uzair63210-png/plus-box/PULSE-Box_Round_3D_model.obj

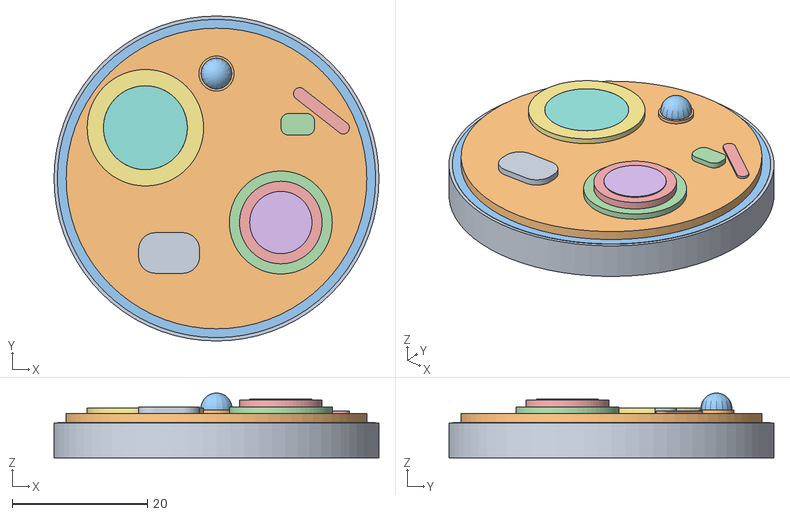
[picture p1: CAD file, 2026-10-22]
PULSE-Box_Round_3D_model.obj
48.0 x 48.0 x 9.60
enclosure
lid
gasket
cell_ring
coin_cell
cell_label
write_coil
coil_core
uv_window
led_base
led_dome
antenna_chip
antenna_strip
