uzair63210-png/plus-box/PULSE-Box_Schematic_Rev-A.pdf

PULSE-Box Tag — Board Schematic | Sheet 1/2 · analog front-end, power, MCU and 433.92 MHz FSK transmitter · Rev A

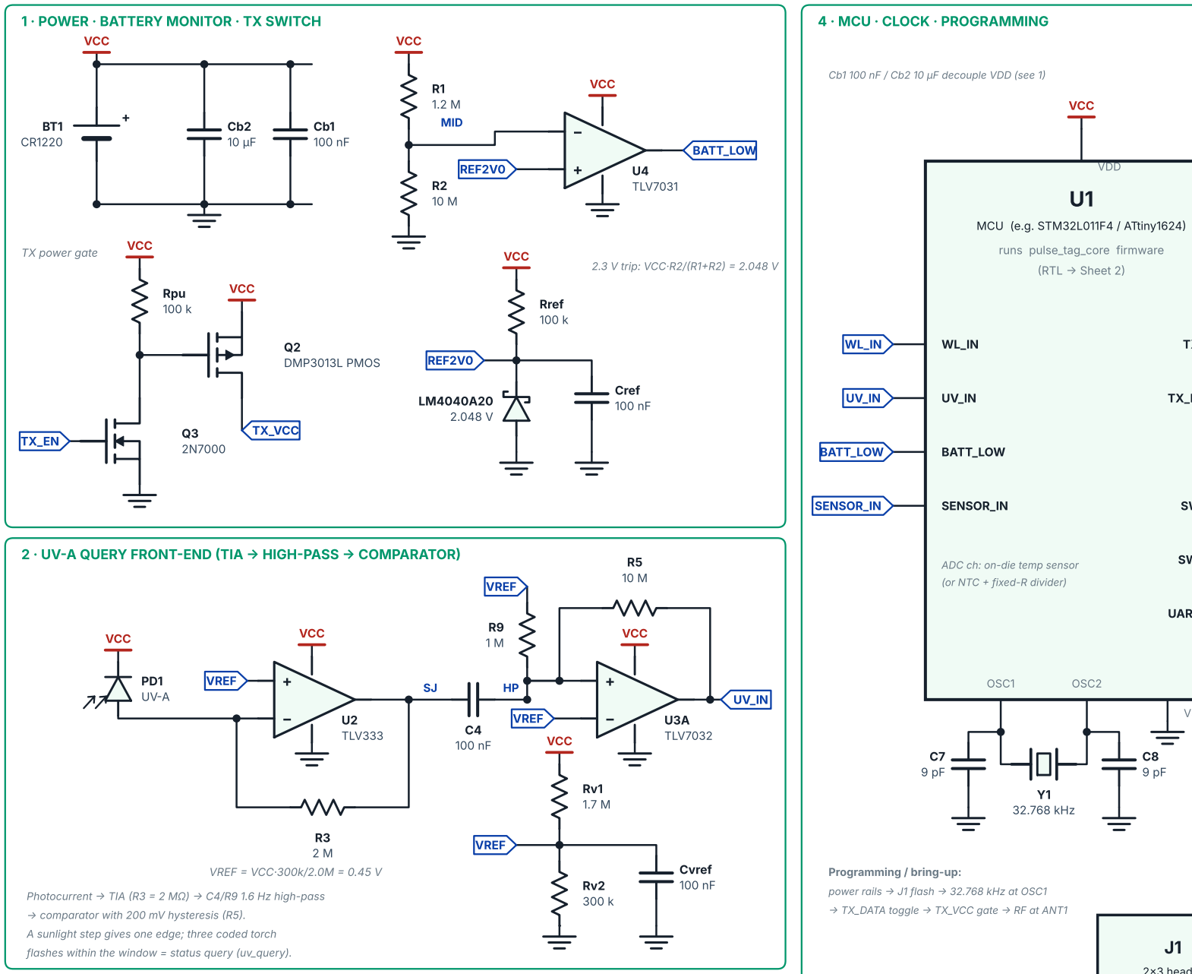
[picture p2: figure]
1 · POWER · BATTERY MONITOR · TX SWITCH; VCC; TLV7031; REF2V0; BATT_LOW; MID; Rref 100 k; Cref 100 nF; 2.3 V trip: VCC·R2/(R1+R2) = 2.048 V; Q2 DMP3013L PMOS; TX_VCC; Rpu 100 k; TX power gate; TLV333; VREF; TLV7032; Cvref 100 nF; VREF = VCC·300k/2.0M = 0.45 V; 4 · MCU · CLOCK · PROGRAMMING; MCU (e.g. STM32L011F4 / ATtiny1624); runs pulse_tag_core firmware; (RTL → Sheet 2); SENSOR_IN; ADC ch: on-die temp sensor (or NTC + fixed-R divider); VDD; OSC1; OSC2; Y1 32.768 kHz; Programming / bring-up:

### 2 · UV-A QUERY FRONT-END (TIA → HIGH-PASS → COMPARATOR)

Photocurrent → TIA (R3 = 2 MΩ) → C4/R9 1.6 Hz high-pass

→ comparator with 200 mV hysteresis (R5).

A sunlight step gives one edge; three coded torch
flashes within the window = status query (uv_query).

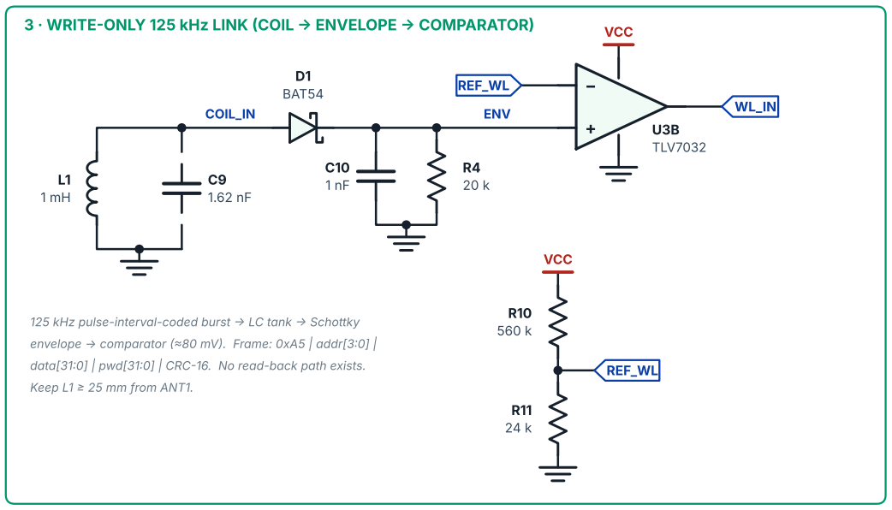
[picture p3: figure]
COIL_IN; D1 BAT54; ENV; TLV7032; REF_WL; VCC; Keep L1 ≥ 25 mm from ANT1.

### 3 · WRITE-ONLY 125 kHz LINK (COIL → ENVELOPE → COMPARATOR)

125 kHz pulse-interval-coded burst → LC tank → Schottky

envelope → comparator (≈80 mV). Frame: 0xA5 | addr[3:0] |
data[31:0] | pwd[31:0] | CRC-16. No read-back path exists.
TX_EN | TX_EN
TX_DATA | TX_DATA
SWDIO | SWDIO
SWCLK | SWCLK
UART_TX | UART_TX

VSS

Cb1 100 nF / Cb2 10 µF decouple VDD (see 1)

2×3 header
SWD + UART
VCC | 1
GND | 2
SWDIO | 3
SWCLK | 4
UART_TX | 5
NC × | 6

power rails → J1 flash → 32.768 kHz at OSC1

→ TX_DATA toggle → TX_VCC gate → RF at ANT1

### 5 · 433.92 MHz FSK TRANSMITTER (SAW-STABILISED COMMON-BASE COLPITTS)

TX_VCC

RB1
10 k

RB2
10 k

CB
1 nF
VB | Q1
| BFP420

L3
27 nH RFC

COL

SAW1

433.92 MHz

1 | 3 2

C1
15 pF

RE*
1.5 k

C2
33 pF

VC

D2
1SV325

R6
100 k

TX_DATA

Cout
10 pF

C12
12 pF*

L2
12 nH

C13
12 pF*

ANT1
433.92 MHz helical
or PCB meander

RF_OUT

π match (C12 · L2 · C13) — pads tunable on bench

TX_EN → Q3 → Q2 gates TX_VCC (radio is unpowered between packets).

TX_DATA (0/VCC) through R6 pulls varactor D2 → ±36 kHz FSK shift.

Emitter node needs a DC return: RE (dashed) is NOT in the BOM — see review note R2.

* = simulated / bench-tuned value

TX link budget (from RTL)

433.92 MHz · 2-FSK ±36 kHz · NRZ 4096 bit/s (32.768 kHz ÷ 8)

96-bit frame: preamble 0xAA (8) | sync 0x2DD4 (16) | box ID (32) |
status (8) | sample (8) | seq (8) | CRC-16/CCITT (16)

Heartbeat 6 h + jitter; alert back-off 10 s → 300 s; UV query on demand

### DESIGN & REVIEW NOTES

Design

### 1 Pilot option: replace Q1/SAW1/D2 with a sub-GHz SoC module (E22-900M / STM32WL):

TX_DATA→DIN, TX_EN→sleep.

2 UV photodiode needs a clear optical window in the label / enclosure.

3 Solid ground plane under RF; keep L1 ≥ 25 mm from ANT1; π-match pads left tunable.

Review flags (vs. original package)

R1 | BOM/netlist put Q2 source on TX_VCC; drawn here as source = VCC, drain = TX_VCC (correct high-side switch).
R2 | Q1 emitter has no DC path to GND in the BOM → RE ≈ 1–2.2 kΩ added (dashed). Confirm in
| simulation.
R3 | R10/R11 on VCC give 3.0·24/584 ≈ 123 mV, not 80 mV. For 80 mV use R10 ≈ 866 kΩ.
R4 | J1 pin 6 not defined in the source (drawn NC).

## PULSE-Box — Reusable Shelf-Life Monitoring Tag

Board Schematic · power, sensing, MCU, RF

Sheet 1 of 2 · Format A3

Rev A · 2026-10-16

Passives 0603 unless noted · * = tuned value

Team VK26-IITI-AHM-0520

Vishwakarma Awards 2026-27 · Stage 2

Source: netlist.csv, BOM.csv, RTL

Red = power · blue = net name

PULSE-Box Tag — Digital Core (pulse_tag_core.v) | Sheet 2/2 · RTL block schematic: every instance, port and net from the Verilog · Rev A

### wlink_rx

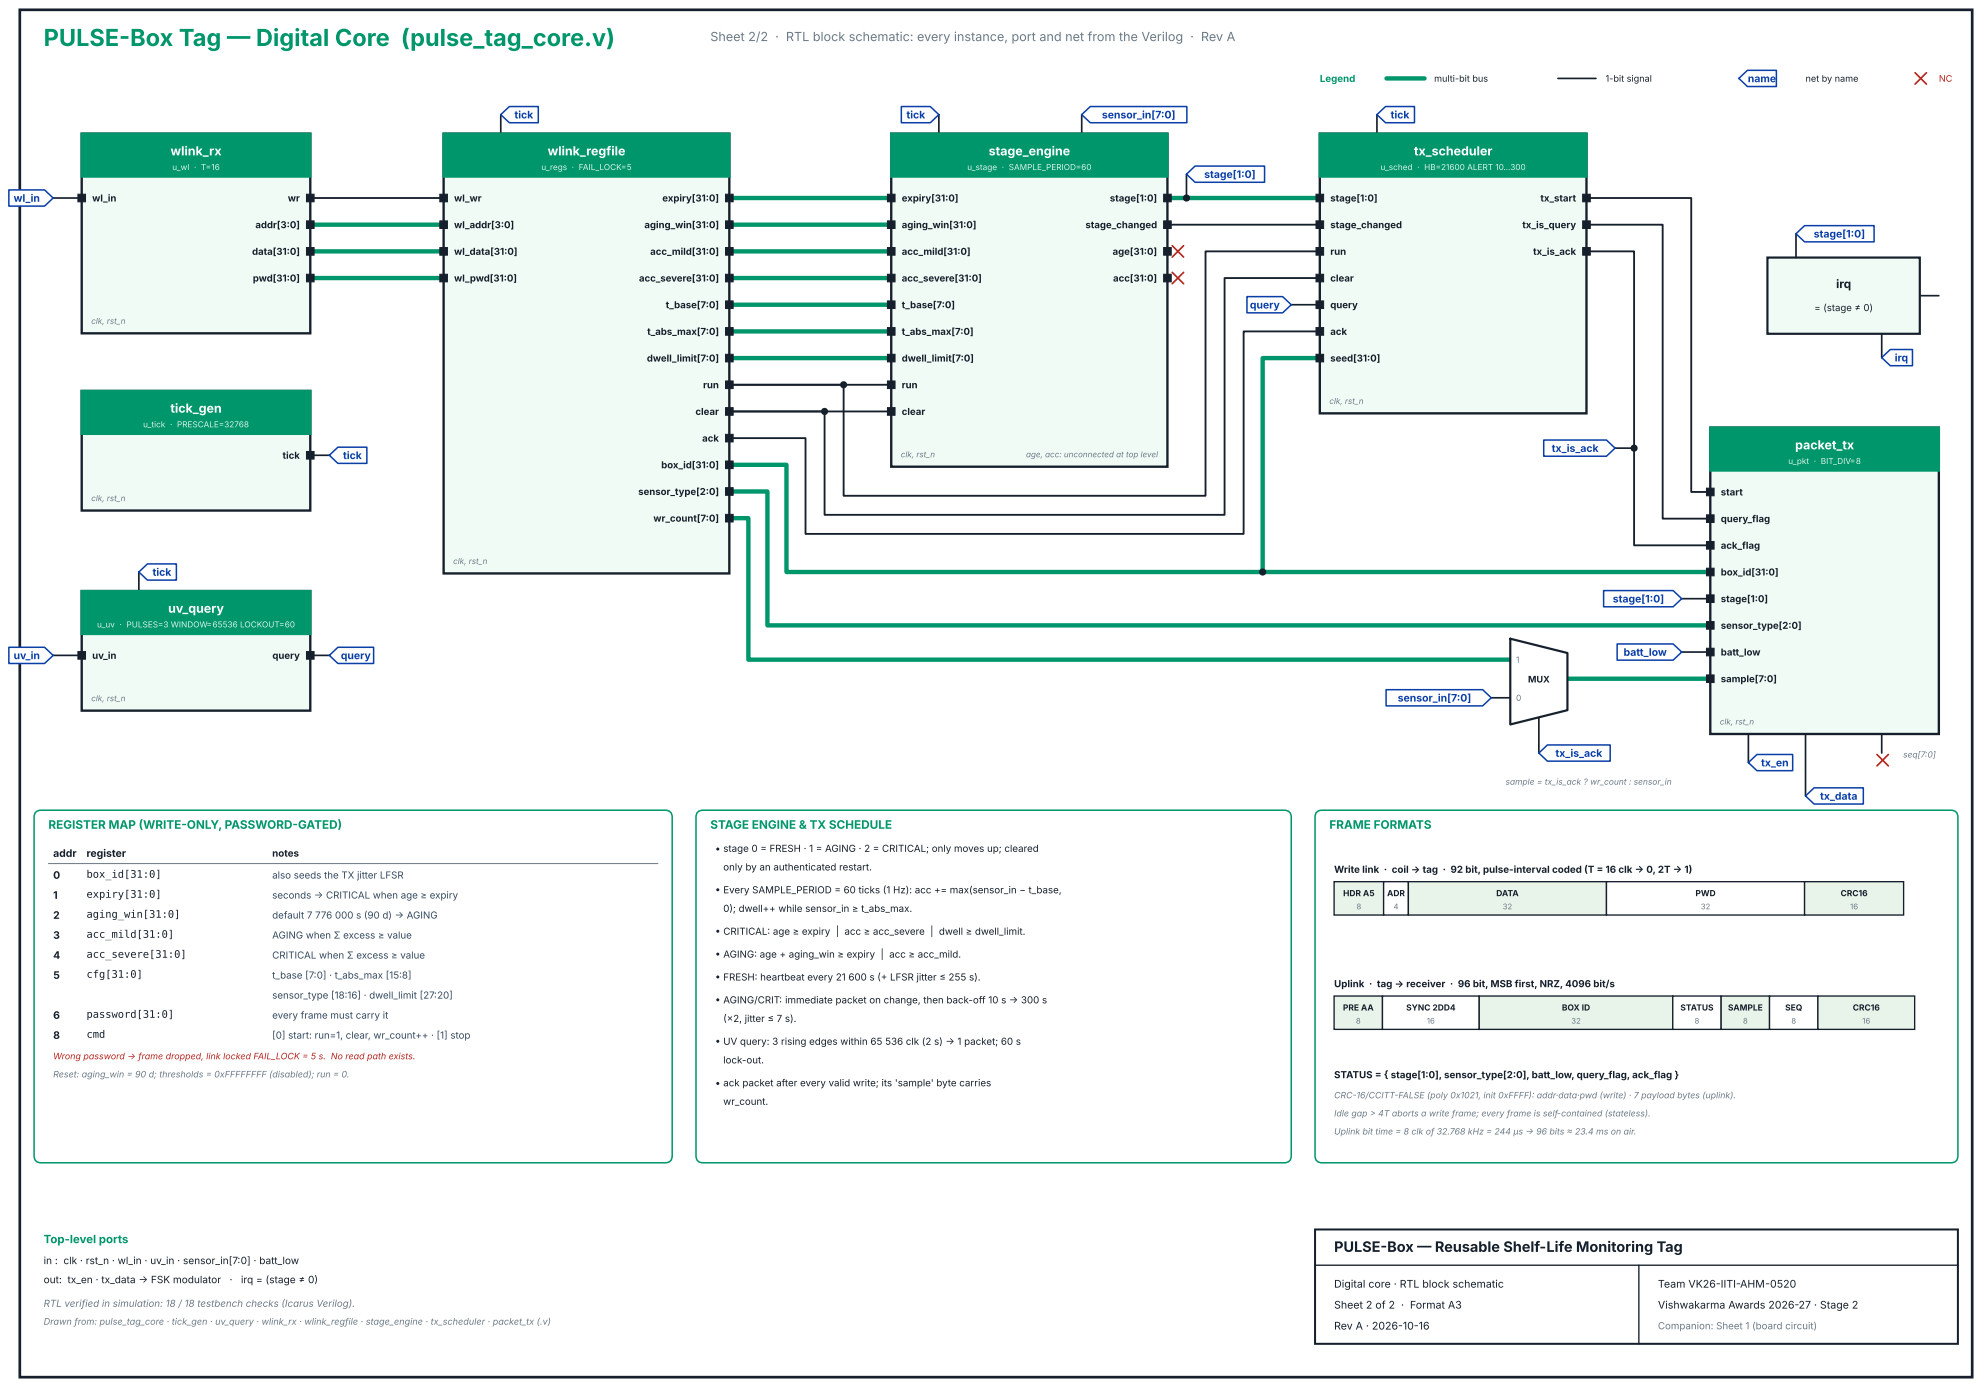
[picture p4: page 2]
clk, rst_n; addr[3:0]; data[31:0]; pwd[31:0]; tick; query; wl_addr[3:0]; wl_data[31:0]; wl_pwd[31:0]; expiry[31:0]; aging_win[31:0]; acc_mild[31:0]; acc_severe[31:0]; t_base[7:0]; t_abs_max[7:0]; dwell_limit[7:0]; run; clear; ack; box_id[31:0]; sensor_type[2:0]; wr_count[7:0]; stage[1:0]; stage_changed; age[31:0]; acc[31:0]; sensor_in[7:0]; seed[31:0]; tx_start; tx_is_query; tx_is_ack; start; query_flag; ack_flag; batt_low; sample[7:0]; MUX; sample = tx_is_ack ? wr_count : sensor_in; tx_data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

age, acc: unconnected at top level

u_uv · PULSES=3 WINDOW=65536 LOCKOUT=60

REGISTER MAP (WRITE-ONLY, PASSWORD-GATED)

STAGE ENGINE & TX SCHEDULE

• stage 0 = FRESH · 1 = AGING · 2 = CRITICAL; only moves up; cleared

only by an authenticated restart.

Write link · coil → tag · 92 bit, pulse-interval coded (T = 16 clk → 0, 2T → 1)

• Every SAMPLE_PERIOD = 60 ticks (1 Hz): acc += max(sensor_in − t_base,

• CRITICAL: age ≥ expiry | acc ≥ acc_severe | dwell ≥ dwell_limit.

• AGING: age + aging_win ≥ expiry | acc ≥ acc_mild.

• FRESH: heartbeat every 21 600 s (+ LFSR jitter ≤ 255 s).

Uplink · tag → receiver · 96 bit, MSB first, NRZ, 4096 bit/s

• AGING/CRIT: immediate packet on change, then back-off 10 s → 300 s

• UV query: 3 rising edges within 65 536 clk (2 s) → 1 packet; 60 s

Wrong password → frame dropped, link locked FAIL_LOCK = 5 s. No read path exists.

Reset: aging_win = 90 d; thresholds = 0xFFFFFFFF (disabled); run = 0.

• ack packet after every valid write; its 'sample' byte carries

CRC-16/CCITT-FALSE (poly 0x1021, init 0xFFFF): addr·data·pwd (write) · 7 payload bytes (uplink).

Idle gap > 4T aborts a write frame; every frame is self-contained (stateless).

Uplink bit time = 8 clk of 32.768 kHz = 244 µs → 96 bits ≈ 23.4 ms on air.

Top-level ports

PULSE-Box — Reusable Shelf-Life Monitoring Tag

out: tx_en · tx_data → FSK modulator · irq = (stage ≠ 0)

Digital core · RTL block schematic

Team VK26-IITI-AHM-0520

RTL verified in simulation: 18 / 18 testbench checks (Icarus Verilog).

Vishwakarma Awards 2026-27 · Stage 2

Sheet 2 of 2 · Format A3
Rev A · 2026-10-16

Companion: Sheet 1 (board circuit)
